DWalch/DRG-Proof-Of-Concept/Schematic Designs/Dawson-Raspberry-Pi-Schematic_bb.png

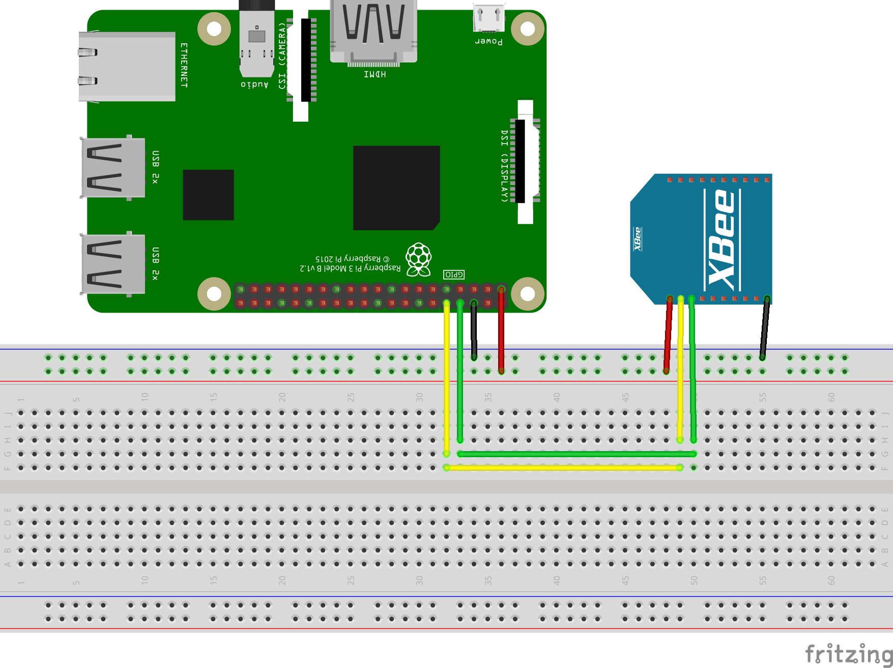
Schematic Designs/Dawson-Raspberry-Pi-Schematic_bb.png
