DWalch/DRG-Proof-Of-Concept/Schematic Designs/Dawson-Raspberry-Pi-Schematic_schem.png

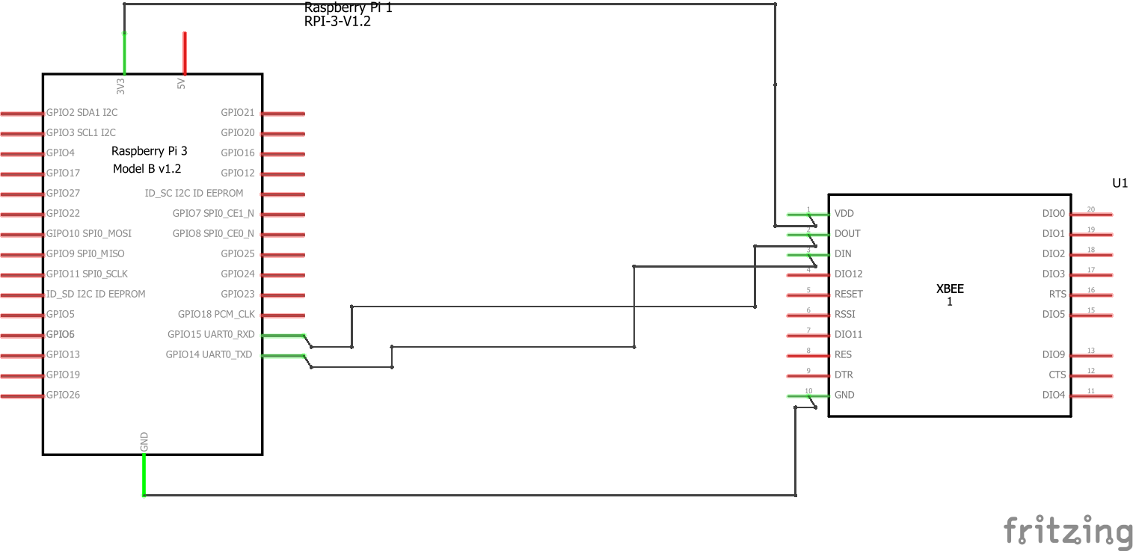
Schematic Designs/Dawson-Raspberry-Pi-Schematic_schem.png
