DWalch/DRG-Proof-Of-Concept/(list of files, drawings)

Other design files:
Schematic Designs/Dawson-Arduino-Uno-Schematic.fzz
Schematic Designs/Dawson-Raspberry-Pi-Schematic.fzz
